bkenololo/DTMF-Oscillator/02_Wien_Bridge_Studies/README.md

# Wien bridge studies

- **V1:** [Initial 10 nF study](wien_bridge_lookup/README.md).
- **V2:** [Expanded C sweep and refinement](wien_bridge_expanded_C/START_HERE.html).

For the current pinned component choice and combined output, see [the corrected summing project](../03_Summing_Amplifier/wien_dtmf_summing_corrected/START_HERE.html). V2 historical selections are preserved.
