bkenololo/DTMF-Oscillator/03_Summing_Amplifier/README.md

# Current combined circuit

Open [results and plots](wien_dtmf_summing_corrected/START_HERE.html), [summary](wien_dtmf_summing_corrected/SUMMARY.md), or [running instructions](wien_dtmf_summing_corrected/README.md).

1209 Hz oscillator: **R1=13,082 Ω; R2=13,110 Ω**. Decoder audio is in `wien_dtmf_summing_corrected/audio/`.
