bkenololo/DTMF-Oscillator/01_Project_Documents/Perhitungan.docx

# Perhitungan Lengkap Wien-Bridge Oscillator untuk DTMF 4

Dua osilator Wien-Bridge untuk membangkitkan sinyal DTMF angka 4, yaitu frekuensi 770 Hz dan 1209 Hz.

Spesifikasi dasar perancangan:

Parameter | Osilator 1 | Osilator 2
Frekuensi target | 770 Hz | 1209 Hz
Jenis gelombang | Sinusoidal | Sinusoidal
Topologi | Wien-Bridge | Wien-Bridge
Op-amp | TL074 | TL074
Catu daya | ±12 V | ±12 V
Kapasitor yang dipilih | 10 nF | 10 nF
Metode stabilisasi amplitudo | Dioda 1N4148 | Dioda 1N4148

Pada dokumen ini digunakan jaringan RC simetris, yaitu:

R_s =R_p =R

C_s =C_p =C

dengan:

- R_s ,C_s = resistor dan kapasitor pada jalur seri,
- R_p ,C_p = resistor dan kapasitor pada jalur paralel,
- V_o = tegangan keluaran osilator,
- V_(+) = tegangan masukan non-inverting op-amp.

# 1. Penurunan Persamaan Frekuensi Wien-Bridge

# 1.1. Impedansi jalur seri

Untuk resistor dan kapasitor yang dihubungkan seri:

Z_s =R+1/(sC)

Dengan menyamakan penyebut:

Z_s =(1+sRC)/(sC)

  1.2. Impedansi jalur paralel

Untuk resistor dan kapasitor yang dihubungkan paralel:

Z_p =R∥1/(sC)

Menggunakan rumus impedansi paralel:

Z_p =(R(1/(sC)))/(R+1/(sC))

Sehingga:

Z_p =R/(1+sRC)

## 1.3. Faktor umpan balik

Karena kedua impedansi membentuk pembagi tegangan, maka faktor umpan balik adalah:

β(s)=(V_(+) (s))/(V_o (s))=(Z_p)/(Z_s +Z_p)

Substitusikan hasil sebelumnya:

β(s)=(R/(1+sRC))/((1+sRC)/(sC)+R/(1+sRC))

Setelah penyederhanaan diperoleh:

β(s)=(sRC)/((sRC)^2 +3sRC+1)

Atau dapat ditulis sebagai:

β(s)=1/(3+sRC+1/(sRC))

## 1.4. Menentukan syarat fasa

Untuk analisis sinyal sinusoidal, digunakan:

s=jω

Sehingga:

β(jω)=1/(3+j(ωRC-1/(ωRC)))

Agar memenuhi syarat fasa osilasi Barkhausen, bagian imajiner penyebut harus nol:

ωRC-1/(ωRC)=0

Maka:

(ωRC)^2 =1

ω_0 =1/(RC)

Karena:

ω_0 =2πf_0

maka diperoleh persamaan frekuensi osilasi:

f_0 =1/(2πRC)

## 1.5. Menentukan penguatan minimum

Pada frekuensi osilasi, berlaku ω_0 RC=1 , sehingga:

β(jω_0 )=1/3

Menurut kondisi magnitudo Barkhausen:

|Aβ|=1

A(1/3)=1

sehingga:

A=3

Karena digunakan penguat non-inverting:

A=1+(R_f)/(R_g)

maka:

3=1+(R_f)/(R_g)

R_f =2R_g

Jadi, secara ideal penguatan efektif penguat harus mendekati 3 ketika osilasi sudah stabil.

# 2. Perhitungan Osilator Pertama (770 Hz)

Diketahui:

f_1 =770 Hz

C=10 nF=10×10^(-9) F

Dari persamaan:

f_0 =1/(2πRC)

maka untuk mencari R :

R=1/(2πf_0 C)

Substitusikan:

R_1 =1/(2π(770)(10×10^(-9) ))

R_1 =20 669.47 Ω≈20.67 kΩ

Nilai tersebut adalah nilai resistor ideal yang digunakan pada kedua posisi resistor jaringan Wien.

## 2.1. Pemilihan komponen sebenarnya

Agar mudah dirakit dengan komponen standar, dipilih dua resistor seri:

R=20 kΩ+680 Ω

R=20.68 kΩ

Komponen jaringan Wien-Bridge 770 Hz:

Komponen | Nilai
R_s | 20 k Ω + 680 Ω (seri)
R_p | 20 k Ω + 680 Ω (seri)
C_s | 10 nF
C_p | 10 nF

## 2.2. Verifikasi frekuensi teoritis

f_(1,hitung) =1/(2π(20680)(10×10^(-9) ))

f_(1,hitung) =769.608 Hz

Persentase kesalahan terhadap target:

% Error=(|f_(hitung) -f_(target) |)/(f_(target))×100%

% Error_1 =(|769.608-770|)/770×100%

% Error_1 ≈0.051%

# 3. Perhitungan Osilator Kedua (1209 Hz)

Diketahui:

f_2 =1209 Hz

C=10 nF

Gunakan:

R=1/(2πf_0 C)

Substitusikan:

R_2 =1/(2π(1209)(10×10^(-9) ))

R_2 =13 164.18 Ω≈13.16 kΩ

## 3.1. Pemilihan komponen sebenarnya

Gunakan resistor seri:

R=13 kΩ+150 Ω

R=13.15 kΩ

Komponen jaringan Wien-Bridge 1209 Hz:

Komponen | Nilai
R_s | 13 k Ω + 150 Ω (seri)
R_p | 13 k Ω + 150 Ω (seri)
C_s | 10 nF
C_p | 10 nF

## 3.2. Verifikasi frekuensi teoritis

f_(2,hitung) =1/(2π(13150)(10×10^(-9) ))

f_(2,hitung) =1210.304 Hz

Persentase kesalahan:

% Error_2 =(|1210.304-1209|)/1209×100%

% Error_2 ≈0.108%

# 4. Perbandingan Hasil Kedua Osilator

Parameter | Osilator 1 | Osilator 2
Target | 770 Hz | 1209 Hz
R ideal | 20.669 k Ω | 13.164 k Ω
R dipilih | 20.68 k Ω | 13.15 k Ω
C dipilih | 10 nF | 10 nF
Hasil nominal | 769.608 Hz | 1210.304 Hz
Error absolut | 0.392 Hz | 1.304 Hz
Error relatif | 0.051% | 0.108%

# 5. Perhitungan Penguatan Kedua Osilator

Penguatan kedua osilator menggunakan komponen yang sama, karena frekuensi osilasi ditentukan oleh jaringan RC yang berbeda.

## 5.1. Menghitung penguatan ideal

Dari syarat Barkhausen sebelumnya:

A=3

Untuk penguat non-inverting:

A=1+(R_f)/(R_g)

Jika ditentukan:

R_g =10 kΩ

maka:

R_f =2(10 kΩ)

R_f =20 kΩ

Namun, agar osilasi dapat mulai, penguatan awal dibuat sedikit lebih besar dari 3.

## 5.2. Memilih resistor untuk stabilisasi amplitudo

Dipilih nilai:

Komponen | Nilai
R_g | 10 k Ω
R_(f1) | 15 k Ω
R_(f2) | 7.5 k Ω
D_1 dan D_2 | 1N4148 antiparalel

## 5.3. Penguatan awal ketika dioda OFF

Pada kondisi awal, kedua dioda belum menghantarkan secara berarti.

Resistansi total jalur umpan balik:

R_f =R_(f1) +R_(f2)

R_f =15+7.5=22.5 kΩ

Sehingga:

A_(awal) =1+22.5/10

A_(awal) =3.25

Dengan faktor umpan balik Wien:

β=1/3

maka penguatan loop awal adalah:

L=A_(awal) β

L=3.25(1/3)

L_(awal) ≈1.083

Karena L_(awal) >1 , maka dalam model linear ideal gangguan kecil pada frekuensi yang sesuai akan mengalami penguatan sehingga osilasi dapat tumbuh.

## 5.4. Penguatan ketika dioda mulai ON

Ketika amplitudo meningkat, kedua dioda menghantarkan bergantian sesuai polaritas sinyal. Dioda yang menghantarkan mengurangi resistansi efektif yang dipasang paralel dengan R_(f2) .

Sebagai pendekatan batas jika bagian R_(f2) hampir seluruhnya ter-bypass:

R_f ≈R_(f1) =15 kΩ

Sehingga:

A_(batas) ≈1+15/10

A_(batas) ≈2.5

Penguatan loop pada kondisi batas tersebut:

L≈2.5(1/3)

L≈0.833<1

Artinya, jika penguatan berkurang terlalu jauh, amplitudo akan menurun kembali. Dalam keadaan osilasi mantap, dioda tidak terus-menerus bekerja seperti hubungan pendek ideal. Konduksinya berubah sepanjang gelombang sehingga penguatan efektif untuk komponen fundamental menyesuaikan sampai loop tidak lagi mengalami pertumbuhan atau peredaman bersih.

# 6. Perkiraan Titik Kerja Dioda

Sebelum dioda menghantarkan, arus pada rangkaian umpan balik dapat didekati dengan:

I_f =(V_o)/(R_g +R_(f1) +R_(f2))

Total resistansi:

R_(total) =10+15+7.5=32.5 kΩ

Tegangan pada resistor 7.5 k Ω :

V_(R_(f2)) =I_f R_(f2)

V_(R_(f2)) =7.5/32.5V_o

V_(R_(f2)) ≈0.231V_o

Jika digunakan pendekatan tegangan maju dioda silikon 1N4148 sebesar 0.65 V:

0.65≈0.231V_(o,puncak)

V_(o,puncak) ≈2.82 V

Jadi, pengendalian amplitudo mulai berpengaruh secara signifikan ketika keluaran mencapai sekitar 2.8 V puncak.

# 7. Pemeriksaan Kemampuan Op-Amp TL074

Untuk sinyal:

v_o (t)=V_p sin(2πft)

Turunannya adalah:

(dv_o)/(dt)=2πfV_p cos(2πft)

Kecepatan perubahan maksimum:

SR_(min) =2πfV_p

Jika digunakan amplitudo pemeriksaan 5 V puncak:

Parameter | Osilator 1 | Osilator 2
Frekuensi | 770 Hz | 1209 Hz
Amplitudo pemeriksaan | 5 Vp | 5 Vp
SR_(min) | 0.0242 V/ μ s | 0.0380 V/ μ s

TL074 mempunyai slew rate tipikal sekitar 13 V/ μ s dan gain-bandwidth sekitar 3 MHz, sehingga secara spesifikasi dasar memadai untuk dua frekuensi audio ini.

# 8. Tabel Daftar Semua Nilai Komponen Dua Osilator

Komponen | Osilator 1 (770 Hz) | Osilator 2 (1209 Hz)
R seri Wien ( R_s ) | 20 k Ω + 680 Ω | 13 k Ω + 150 Ω
R paralel Wien ( R_p ) | 20 k Ω + 680 Ω | 13 k Ω + 150 Ω
C seri Wien ( C_s ) | 10 nF | 10 nF
C paralel Wien ( C_p ) | 10 nF | 10 nF
Resistor penguatan ( R_g ) | 10 k Ω | 10 k Ω
Resistor feedback ( R_(f1) ) | 15 k Ω | 15 k Ω
Resistor feedback ( R_(f2) ) | 7.5 k Ω | 7.5 k Ω
Dioda D_1 | 1N4148 | 1N4148
Dioda D_2 | 1N4148 | 1N4148
Op-amp | TL074 kanal A | TL074 kanal B
Tegangan suplai | ±12 V | ±12 V

Rangkaian Summing menggunakan Rin 22k Ω dan Rf = 10k Ω

## 8.1. Hasil frekuensi setelah menggunakan komponen standar

Parameter | Osilator 1 | Osilator 2
Frekuensi target | 770 Hz | 1209 Hz
R ideal | 20.669 k Ω | 13.164 k Ω
R setelah penyesuaian | 20.68 k Ω | 13.15 k Ω
C | 10 nF | 10 nF
Frekuensi teoritis | 769.608 Hz | 1210.304 Hz
Error nominal | 0.051% | 0.108%

## 8.2. Daftar belanja komponen dua osilator

Nama komponen | Spesifikasi | Jumlah
Resistor 20 k Ω | Metal film 1/4 W, 1% | 2 buah
Resistor 680 Ω | Metal film 1/4 W, 1% | 2 buah
Resistor 13 k Ω | Metal film 1/4 W, 1% | 2 buah
Resistor 150 Ω | Metal film 1/4 W, 1% | 2 buah
Resistor 10 k Ω | Metal film 1/4 W, 1% | 3 buah
Resistor 15 k Ω | Metal film 1/4 W, 1% | 2 buah
Resistor 7.5 k Ω | Metal film 1/4 W, 1% | 2 buah
Resistor 22 k Ω | Metal film 1/4 W, 1% | 2 buah
Kapasitor 10 nF (103) | Film atau C0G/NP0, toleransi kecil | 4 buah
Dioda 1N4148 | Switching diode | 4 buah
IC TL074 | DIP-14 | 1 buah
Kapasitor 100 nF (104) | Decoupling catu daya | 2 buah
Kapasitor elektrolit 10 μ F | Minimal 25 V, decoupling suplai | 2 buah

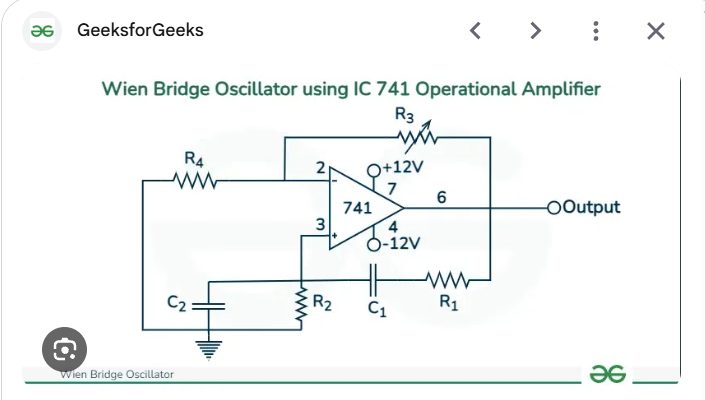
[picture p23: figure]
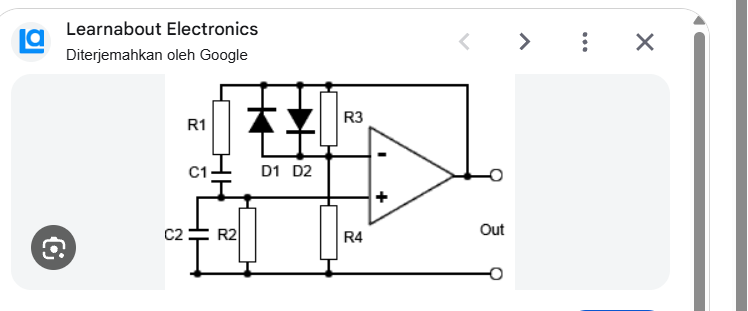
[picture p24: figure]
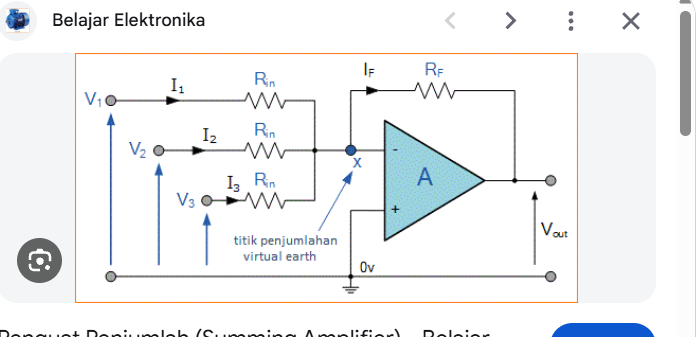
[picture p25: figure]
