bkenololo/DTMF-Oscillator/02_Wien_Bridge_Studies/wien_bridge_expanded_C/resistor_tolerance/figures/resistor_tolerance_770Hz.png

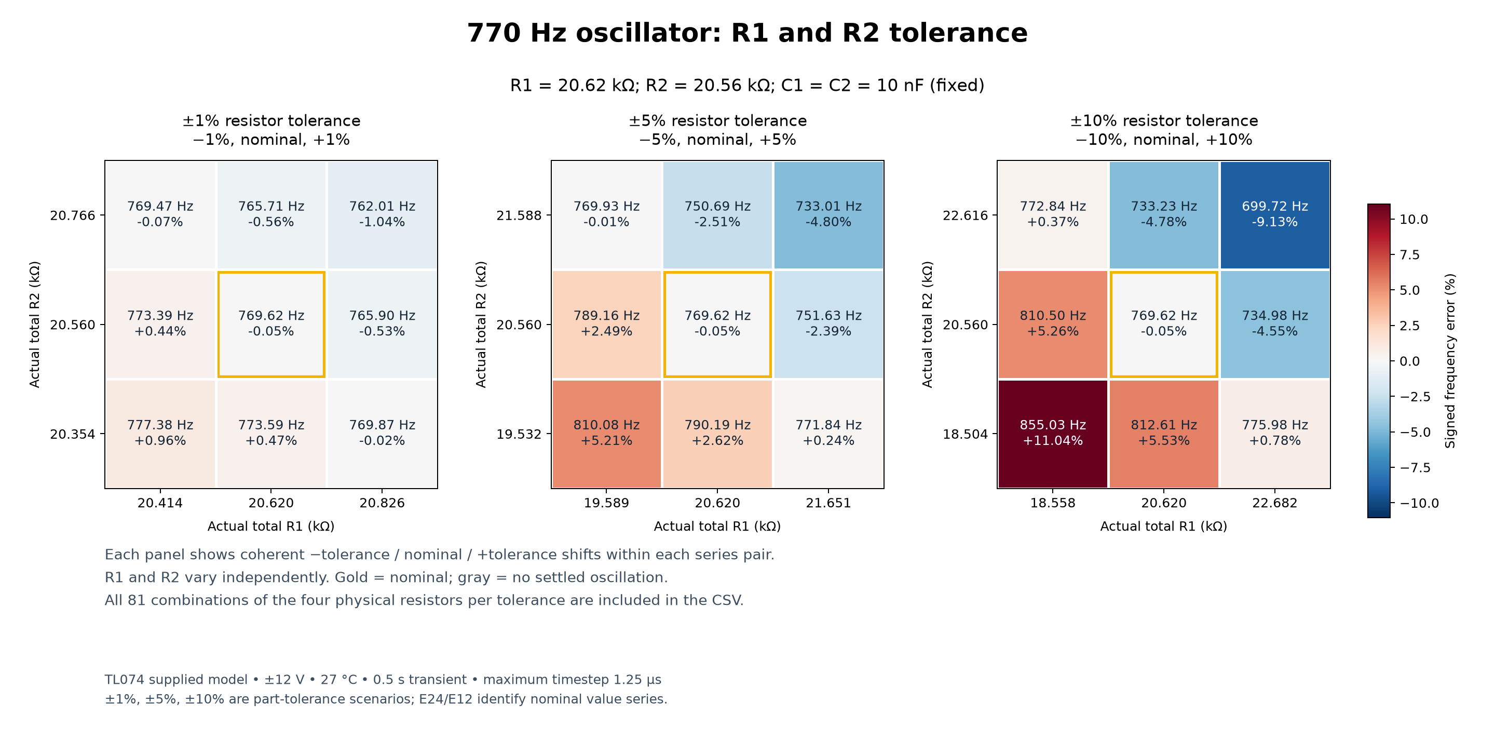
02_Wien_Bridge_Studies/wien_bridge_expanded_C/resistor_tolerance/figures/resistor_tolerance_770Hz.png
