bkenololo/DTMF-Oscillator/02_Wien_Bridge_Studies/wien_bridge_expanded_C/resistor_tolerance/figures/resistor_tolerance_frequency_ranges.png

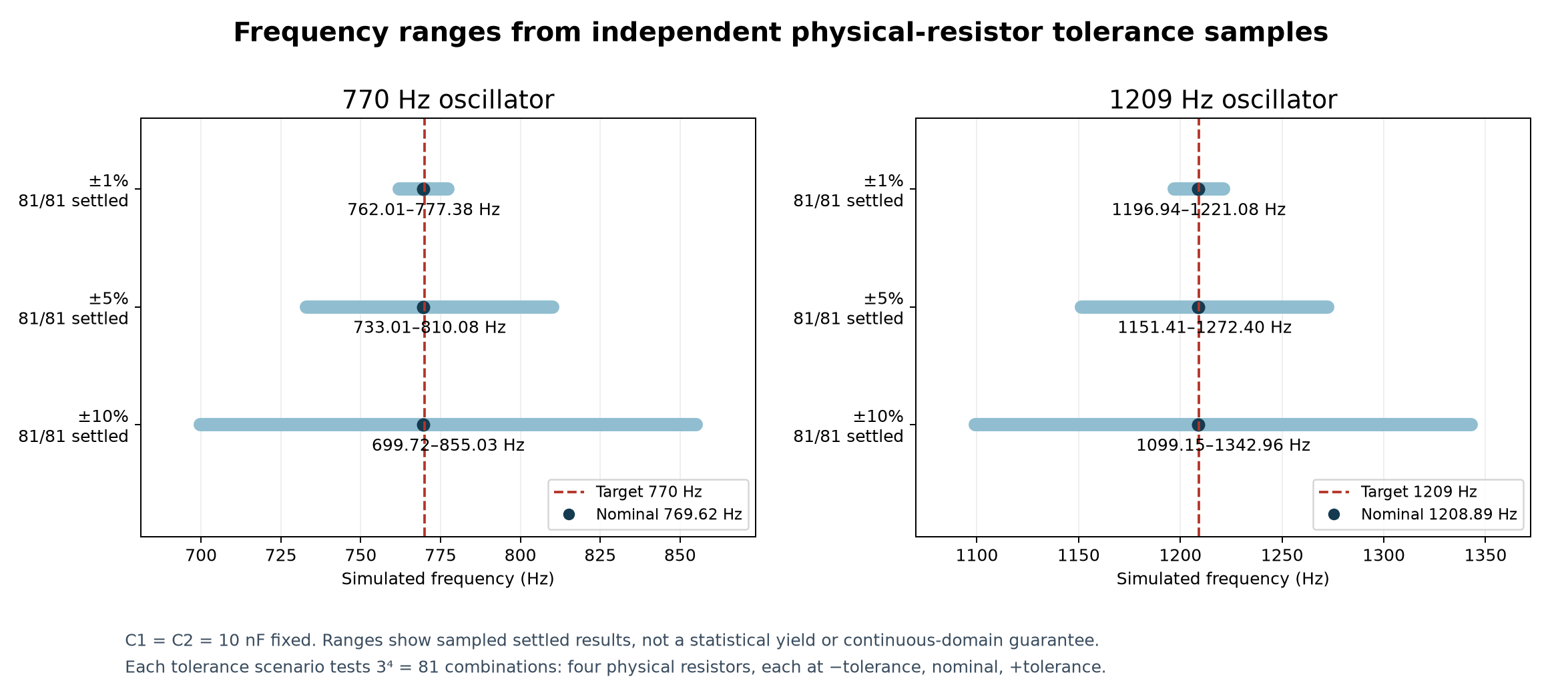
02_Wien_Bridge_Studies/wien_bridge_expanded_C/resistor_tolerance/figures/resistor_tolerance_frequency_ranges.png
