bkenololo/DTMF-Oscillator/03_Summing_Amplifier/wien_dtmf_summing_corrected/figures/fft_wideband.png

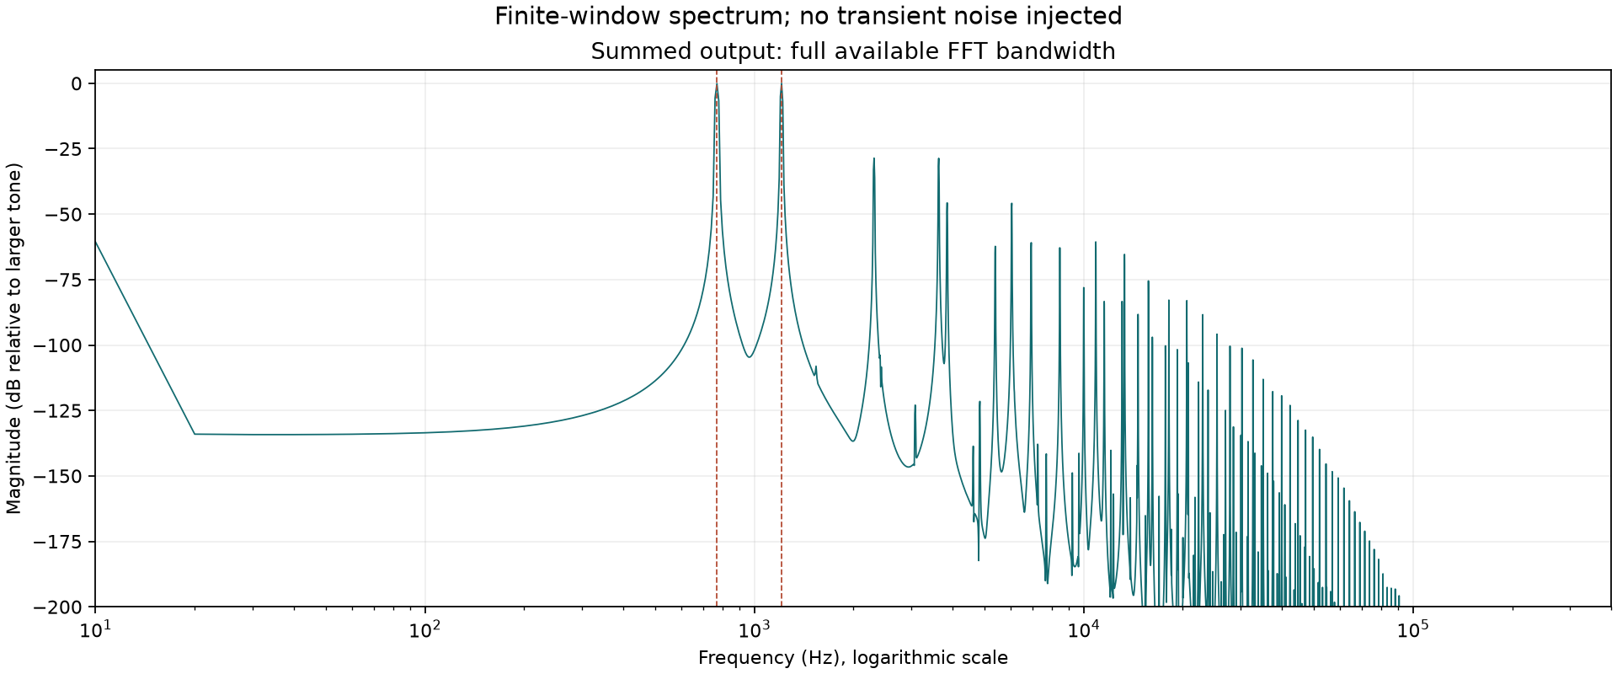
03_Summing_Amplifier/wien_dtmf_summing_corrected/figures/fft_wideband.png
