bkenololo/DTMF-Oscillator/05_Analisis_Hasil_Uji/01_Data_Asli/Rekaman_Osiloskop/NewFile4.bmp

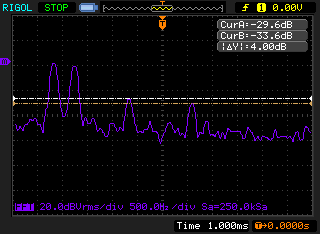
05_Analisis_Hasil_Uji/01_Data_Asli/Rekaman_Osiloskop/NewFile4.bmp
