bkenololo/DTMF-Oscillator/05_Analisis_Hasil_Uji/03_Grafik/ringkasan.png

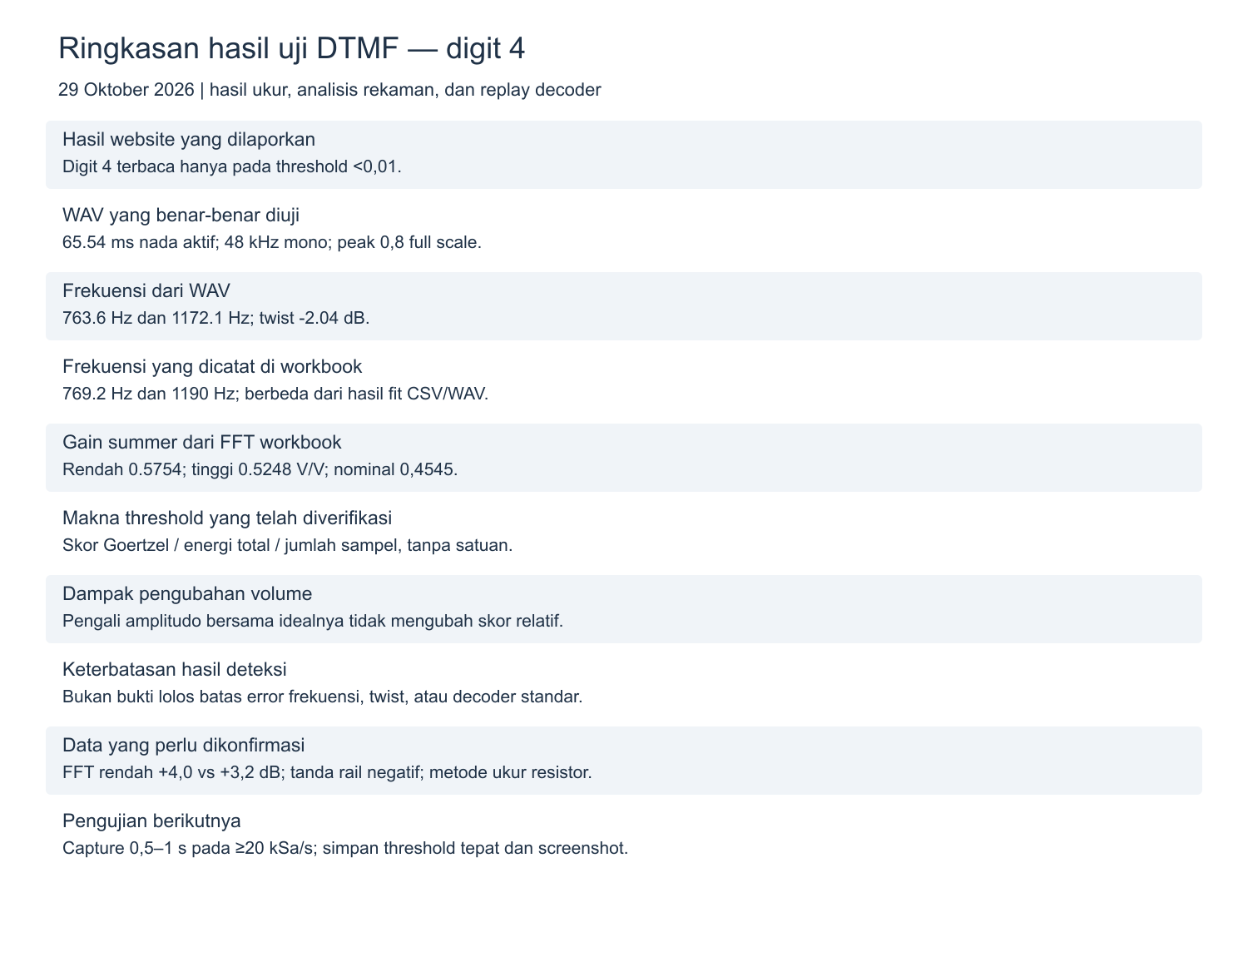
05_Analisis_Hasil_Uji/03_Grafik/ringkasan.png
