bkenololo/DTMF-Oscillator/05_Analisis_Hasil_Uji/03_Grafik/waveform_dan_fft.png

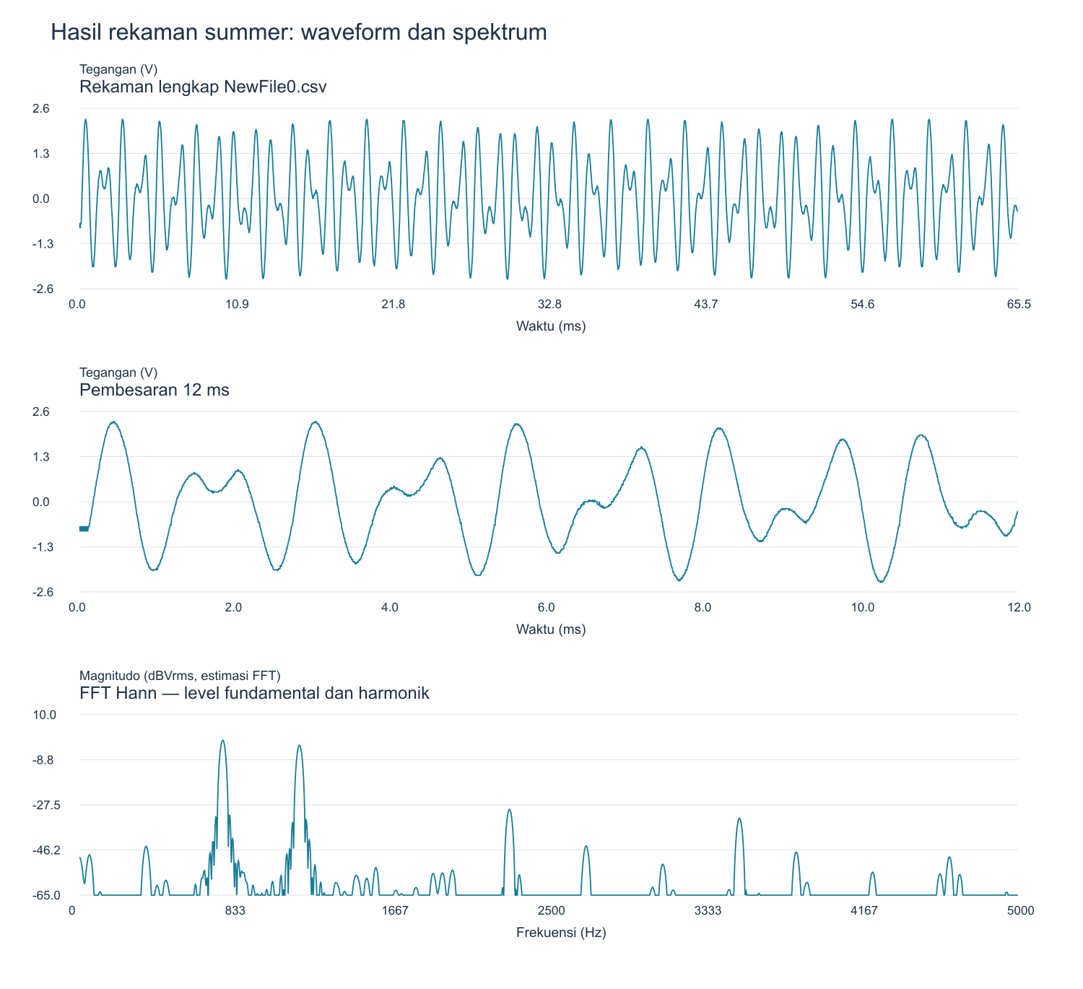
05_Analisis_Hasil_Uji/03_Grafik/waveform_dan_fft.png
