bkenololo/DTMF-Oscillator/schematic-view/DTMF-Oscillator-Schematic-View.png

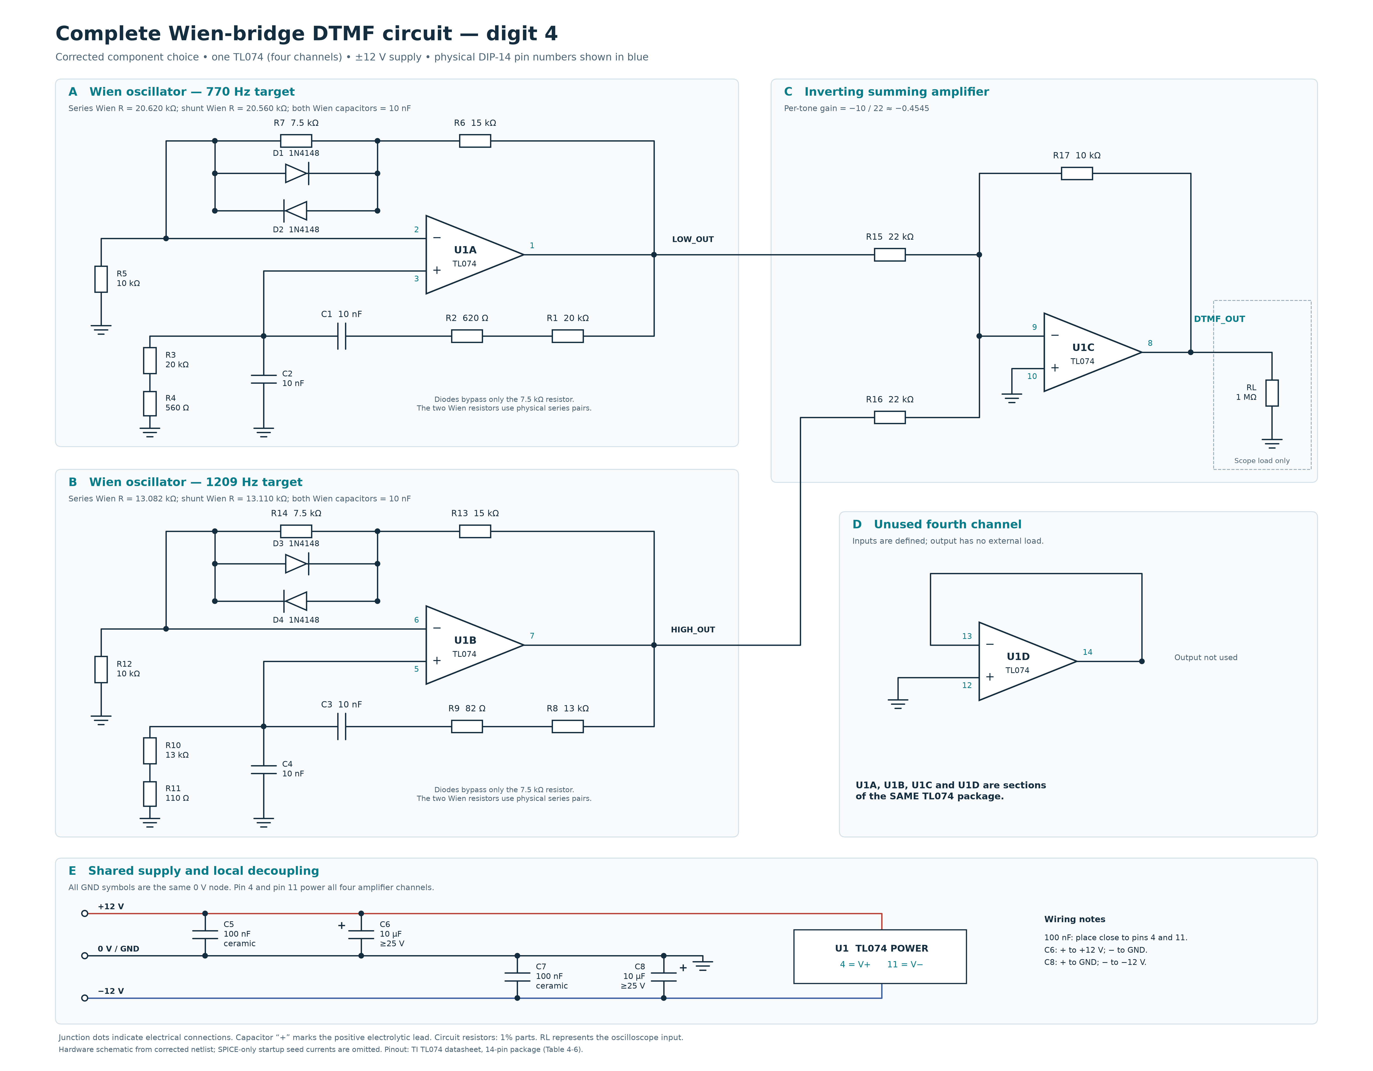
schematic-view/DTMF-Oscillator-Schematic-View.png
