bkenololo/DTMF-Oscillator/02_Wien_Bridge_Studies/wien_bridge_expanded_C/refinement/results/nominal_candidates_1209Hz.csv

target_hz | cap_tolerance_percent | C_nominal_f | C1_offset_percent | C2_offset_percent | C1_f | C2_f | R1_ohm | R2_ohm | R1_parts_ohm | R2_parts_ohm | R1_value_series | R2_value_series | resistor_count | theory_zero_phase_hz | theory_signed_error_percent | theory_abs_error_percent | theory_required_gain | small_signal_gain | theory_small_signal_loop_gain | theory_gain_control_brackets_required | capacitors_nominal | case_id | C_nominal_nF | C_nominal_value_series | simulation_status | oscillation_status | simulated_frequency_hz | simulated_signed_error_percent | simulated_abs_error_percent | steady_state_vpp_v | steady_state_dc_v | envelope_change_fraction | thd_2_to_10_percent | fundamental_peak_v | harmonic_fit_residual_rms_v | settling_time_s | maximum_abs_output_v | output_near_supply_rail | fingerprint | elapsed_wall_s
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
