bkenololo/DTMF-Oscillator/02_Wien_Bridge_Studies/wien_bridge_expanded_C/refinement/results/best_per_nominal_C_1209Hz.csv

case_id | target_hz | C_nominal_f | C_nominal_nF | C_nominal_value_series | R1_ohm | R2_ohm | R1_parts_ohm | R2_parts_ohm | resistor_count | theory_zero_phase_hz | simulated_frequency_hz | simulated_abs_error_percent | steady_state_vpp_v | thd_2_to_10_percent | settling_time_s | oscillation_status
f1209_046ac066d60b | 1209 | 1e-08 | 10.0 | E12/E24 | 13082.0 | 13110.0 | 13000 + 82 | 13000 + 110 | 4 | 1215.2950063751457 | 1209.0978384524221 | 0.008092510539465532 | 6.144114608855222 | 3.8538676106247736 | 0.02 | settled_oscillation
