bkenololo/DTMF-Oscillator/02_Wien_Bridge_Studies/wien_bridge_expanded_C/refinement/results/representatives/1209Hz/trace_excerpt.csv

time_s | output_v
0.000000000000000000e+00 | 3.479807501681160472e-05
2.126502177459654763e-06 | 5.038410360249673004e-05
1.329008831390219458e-05 | 3.785598518225814302e-04
1.071908277827088155e-04 | 5.719949262863732731e-04
2.071908277827090236e-04 | 5.011721676623852014e-04
3.071908277827092859e-04 | 1.311566628370593309e-04
4.071908277827095482e-04 | -3.755039579855497874e-04
5.071908277827098105e-04 | -7.387440940780432615e-04
6.071908277827100728e-04 | -7.069510019513168628e-04
7.071908277827103351e-04 | -2.163273428646124246e-04
8.071908277827105974e-04 | 5.306750613539352622e-04
9.071908277827108597e-04 | 1.132700010650644152e-03
1.007190827782711122e-03 | 1.192254635606167321e-03
1.107190827782711384e-03 | 5.588163182235300576e-04
1.207190827782711647e-03 | -5.274143381441919300e-04
1.307190827782711909e-03 | -1.499659331591011134e-03
1.407190827782712171e-03 | -1.741282108625080097e-03
1.507190827782712433e-03 | -9.511629745873771344e-04
1.607190827782712696e-03 | 6.063179162790445975e-04
1.707190827782712958e-03 | 2.143364708864816705e-03
1.807190827782713220e-03 | 2.718761427041729763e-03
1.907190827782713483e-03 | 1.779290597583276044e-03
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
