bkenololo/DTMF-Oscillator/02_Wien_Bridge_Studies/wien_bridge_expanded_C/refinement/results/representatives/770Hz/trace_excerpt.csv

time_s | output_v
0.000000000000000000e+00 | 3.378035085878499668e-05
2.126701785160093801e-06 | 4.938134523594769947e-05
1.322232371147566126e-05 | 3.705503769672918355e-04
1.068459618648787319e-04 | 5.188883512359092906e-04
2.068459618648789129e-04 | 5.810381665350348697e-04
3.068459618648791752e-04 | 5.169640863462179013e-04
4.068459618648794375e-04 | 3.264167607231337914e-04
5.068459618648796456e-04 | 4.010061919493315268e-05
6.068459618648799079e-04 | -2.839377112962305767e-04
7.068459618648801701e-04 | -5.710761019682198975e-04
8.068459618648804324e-04 | -7.463048458705875922e-04
9.068459618648806947e-04 | -7.525547528162632172e-04
1.006845961864880849e-03 | -5.669455005341510331e-04
1.106845961864881111e-03 | -2.107107060287741478e-04
1.206845961864881373e-03 | 2.504307781662362003e-04
1.306845961864881635e-03 | 7.167553516401765218e-04
1.406845961864881898e-03 | 1.074670301101109549e-03
1.506845961864882160e-03 | 1.222791286562195830e-03
1.606845961864882422e-03 | 1.098323507009410808e-03
1.706845961864882685e-03 | 6.973216379032199253e-04
1.806845961864882947e-03 | 8.309157794118666941e-05
1.906845961864883209e-03 | -6.208225719696469245e-04
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
