bkenololo/DTMF-Oscillator/02_Wien_Bridge_Studies/wien_bridge_expanded_C/refinement/circuits/selected_770Hz/LTspice/verification/LowOscillator_preview.png

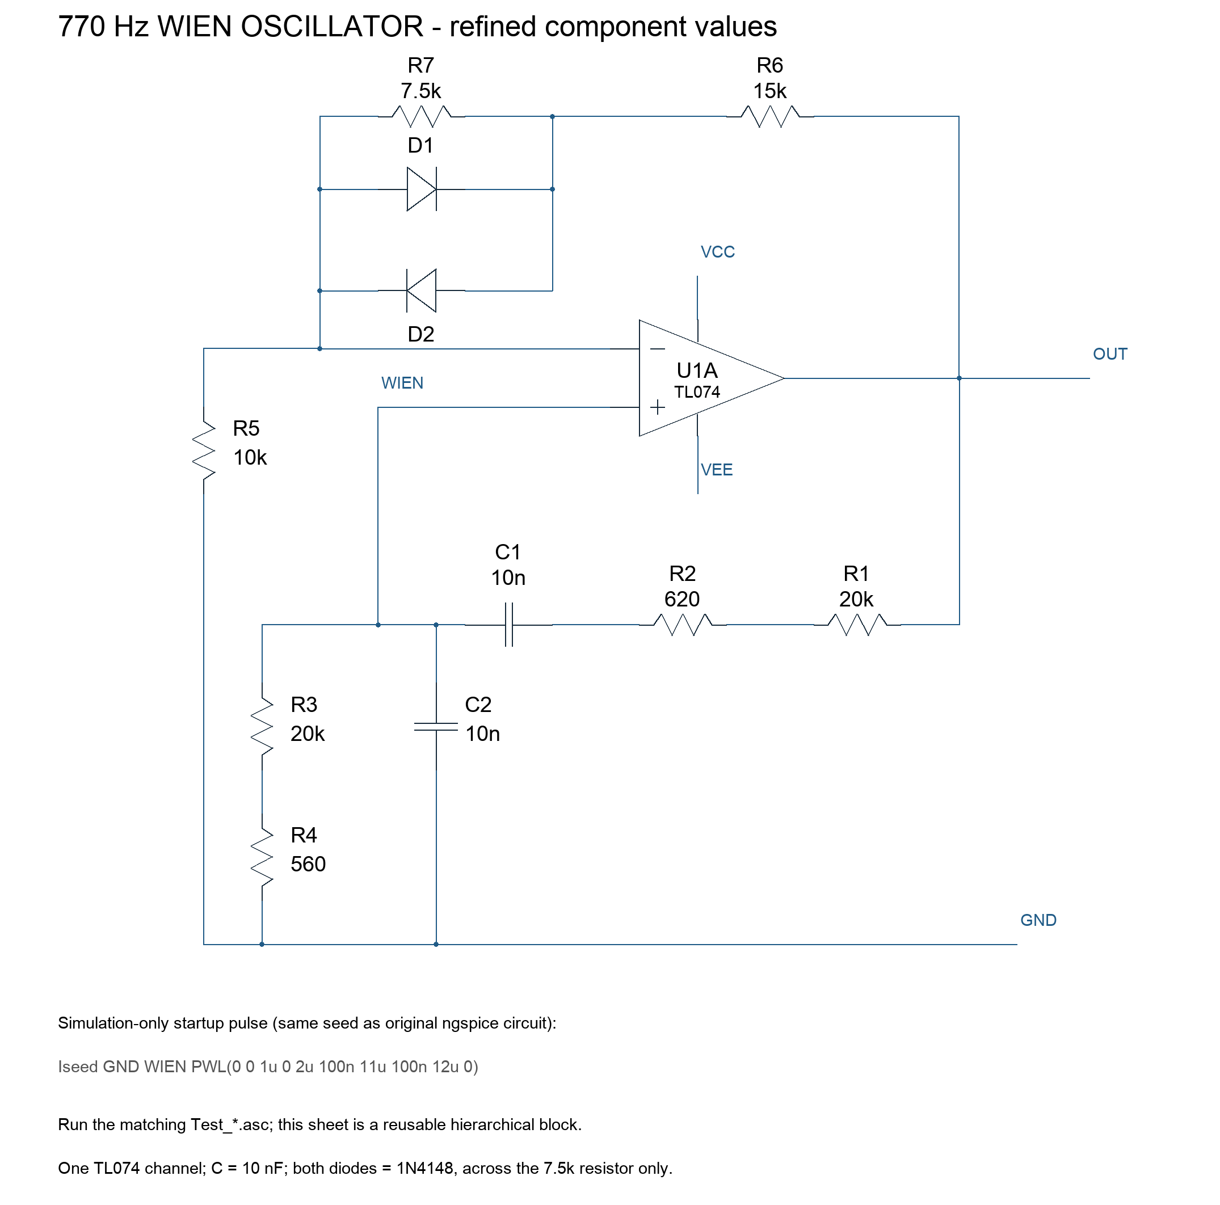
02_Wien_Bridge_Studies/wien_bridge_expanded_C/refinement/circuits/selected_770Hz/LTspice/verification/LowOscillator_preview.png
