bkenololo/DTMF-Oscillator/02_Wien_Bridge_Studies/wien_bridge_expanded_C/verification/results/figures/finalist_770Hz.png

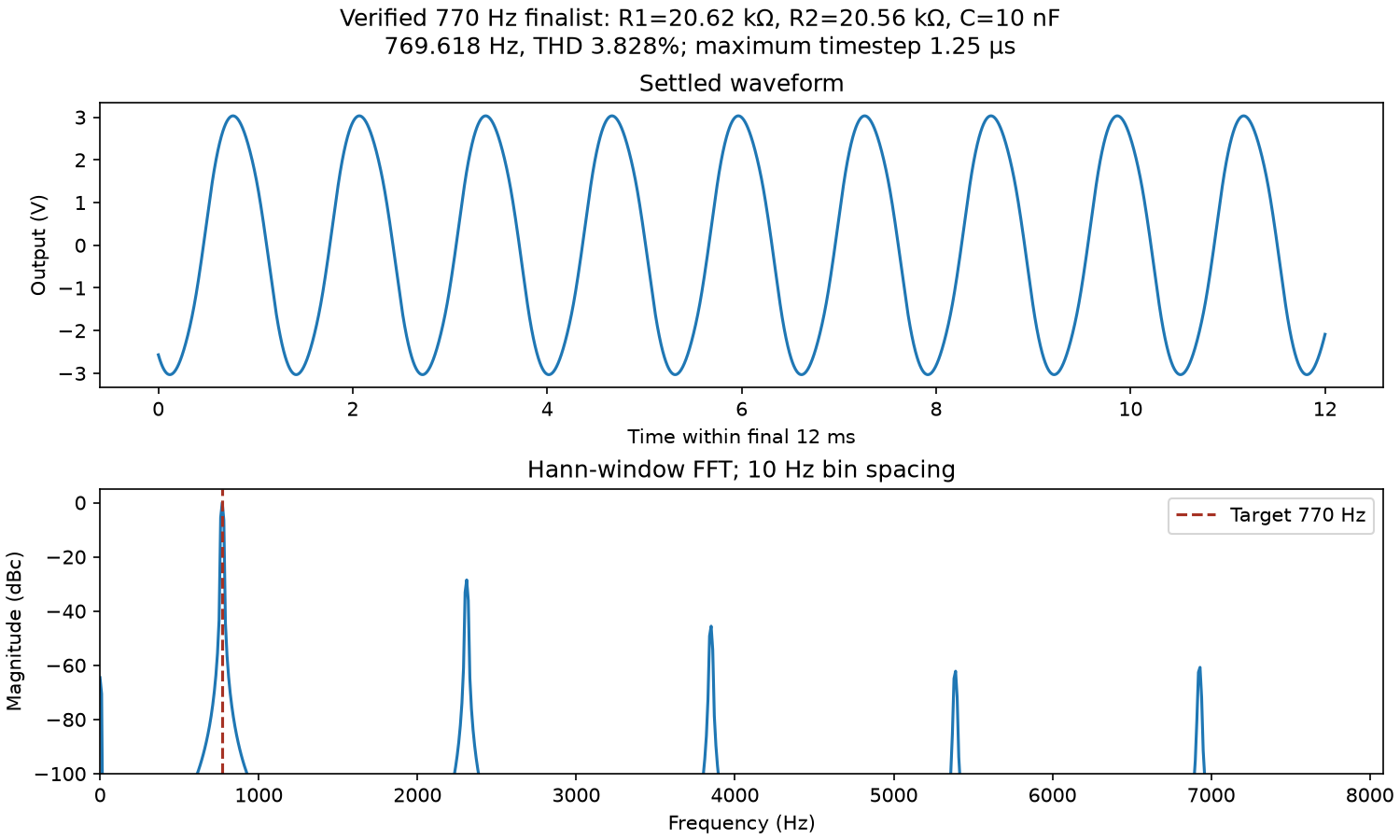
02_Wien_Bridge_Studies/wien_bridge_expanded_C/verification/results/figures/finalist_770Hz.png
