bkenololo/DTMF-Oscillator/03_Summing_Amplifier/wien_dtmf_summing_corrected/circuits/LTspice_DTMF/verification/DTMF4_preview.png

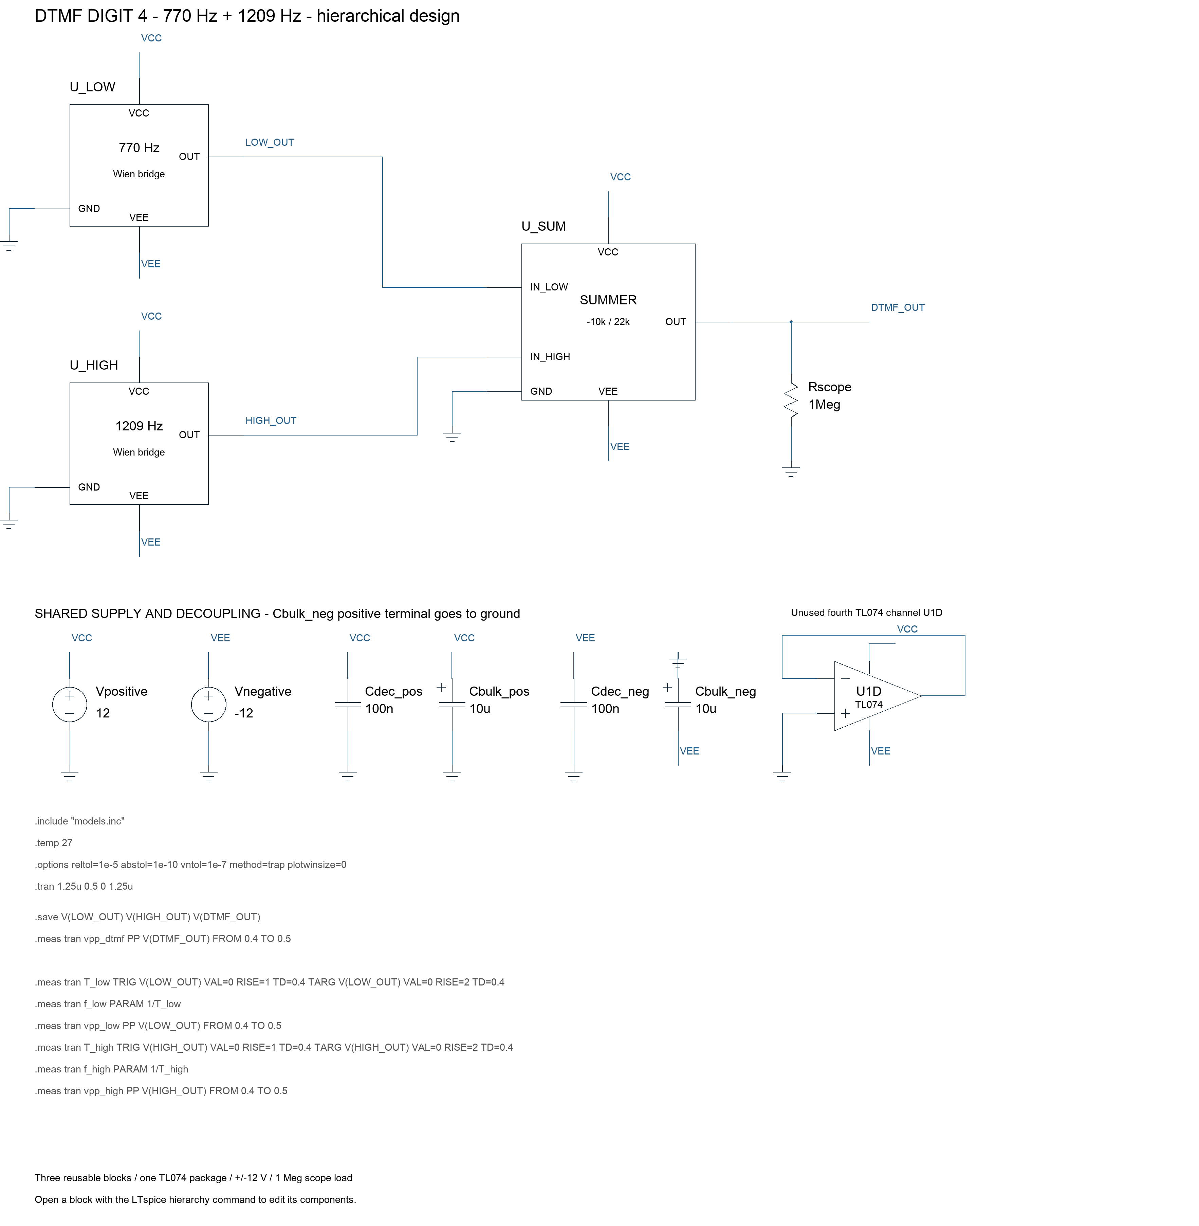
03_Summing_Amplifier/wien_dtmf_summing_corrected/circuits/LTspice_DTMF/verification/DTMF4_preview.png
