bkenololo/DTMF-Oscillator/03_Summing_Amplifier/wien_dtmf_summing_corrected/circuits/LTspice_DTMF/verification/SummingAmplifier_preview.png

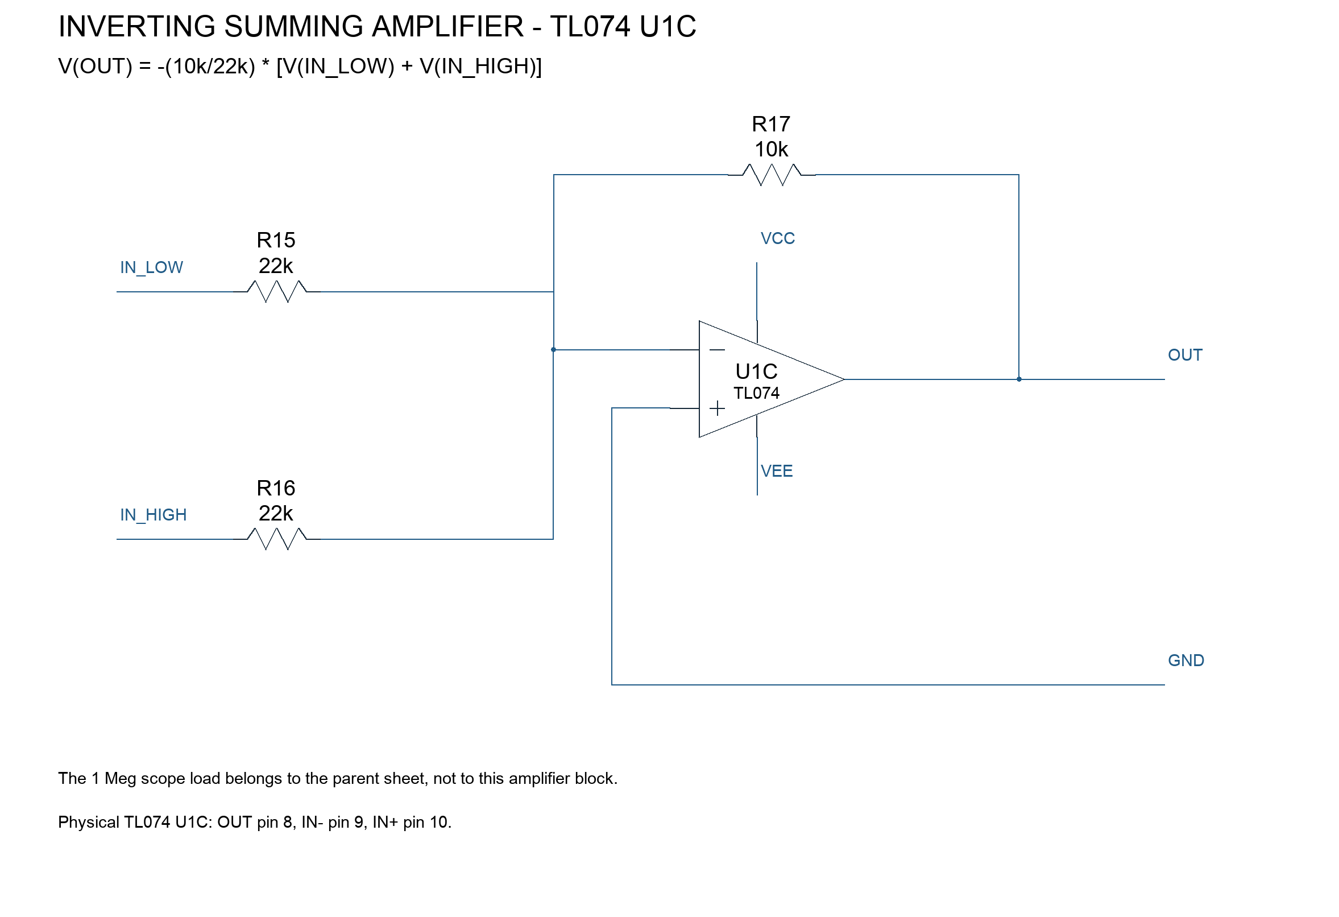
03_Summing_Amplifier/wien_dtmf_summing_corrected/circuits/LTspice_DTMF/verification/SummingAmplifier_preview.png
