bkenololo/DTMF-Oscillator/03_Summing_Amplifier/wien_dtmf_summing_corrected/circuits/LTspice_DTMF/Test_HighOscillator.asc

Rload: R_V; 1Meg
U_TEST: HighOscillator
Vnegative: V_Source; -12
Vpositive: V_Source; 12
Named nets: VCC, VEE, 0, OSC_OUT
1209 Hz OSCILLATOR TEST BENCH
.include "models.inc"
.temp 27
.options reltol=1e-5 abstol=1e-10 vntol=1e-7 method=trap plotwinsize=0
.tran 1.25u 0.5 0 1.25u
.save V(OSC_OUT)
.meas tran T_osc TRIG V(OSC_OUT) VAL=0 RISE=1 TD=0.4 TARG V(OSC_OUT) VAL=0 RISE=2 TD=0.4
.meas tran f_osc PARAM 1/T_osc
.meas tran vpp_osc PP V(OSC_OUT) FROM 0.4 TO 0.5
