bkenololo/DTMF-Oscillator/03_Summing_Amplifier/wien_dtmf_summing_corrected/circuits/LTspice_DTMF/Test_SummingAmplifier.asc

Rload: R_V; 1Meg
U_TEST: SummingAmplifier
VIN_HIGH: V_Source; SINE(0 3 1209)
VIN_LOW: V_Source; SINE(0 3 770)
Vnegative: V_Source; -12
Vpositive: V_Source; 12
Named nets: VCC, VEE, 0, IN_LOW, IN_HIGH, SUM_OUT
SUMMER TEST BENCH - synthetic 3 V peak tones at 770 and 1209 Hz
.include "models.inc"
.temp 27
.options reltol=1e-5 abstol=1e-10 vntol=1e-7 method=trap plotwinsize=0
.tran 1.25u 0.5 0 1.25u
.save V(IN_LOW) V(IN_HIGH) V(SUM_OUT)
.meas tran vpp_sum PP V(SUM_OUT) FROM 0.4 TO 0.5
